cepa/aegir-gps-tracker/firmware/Core/Src/main.c

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
/* Includes ------------------------------------------------------------------*/
#include "main.h"
#include "cmsis_os.h"
#include "fatfs.h"

/* USER CODE BEGIN Includes */

#include <stdio.h>
#include "debug.h"
#include "softuart.h"
#include "ssd1306.h"
#include "ssd1306_fonts.h"
#include "i2c.h"
#include "display.h"
#include "gps.h"
#include "lte.h"
#include "iridium.h"
#include "report.h"

/* USER CODE END Includes */

I2C_HandleTypeDef hi2c1;

IWDG_HandleTypeDef hiwdg;

SPI_HandleTypeDef hspi1;
SPI_HandleTypeDef hspi2;

TIM_HandleTypeDef htim2;

UART_HandleTypeDef huart1;
UART_HandleTypeDef huart2;
UART_HandleTypeDef huart6;

osThreadId mainTaskHandle;
osThreadId displayTaskHandle;
osThreadId sdTaskHandle;
osThreadId gpsTaskHandle;
osThreadId lteTaskHandle;
osThreadId iridiumTaskHandle;
osThreadId keyTaskHandle;
osThreadId sensorTaskHandle;
/* USER CODE BEGIN PV */
extern QueueHandle_t sdQueue;
extern QueueHandle_t lteQueue;
extern QueueHandle_t iridiumQueue;
int lteCounter = 0;
int iridiumCounter = 3600 - 60 * 15; // 15 minutes to first Iridium beacon
/* USER CODE END PV */

void SystemClock_Config(void);
static void MX_GPIO_Init(void);
static void MX_I2C1_Init(void);
static void MX_SPI1_Init(void);
static void MX_SPI2_Init(void);
static void MX_USART1_UART_Init(void);
static void MX_USART2_UART_Init(void);
static void MX_USART6_UART_Init(void);
static void MX_TIM2_Init(void);
static void MX_IWDG_Init(void);
void Main_TaskHandler(void const * argument);
extern void Display_TaskHandler(void const * argument);
extern void SD_TaskHandler(void const * argument);
extern void GPS_TaskHandler(void const * argument);
extern void LTE_TaskHandler(void const * argument);
extern void Iridium_TaskHandler(void const * argument);
extern void Key_TaskHandler(void const * argument);
extern void Sensor_TaskHandler(void const * argument);

/* USER CODE BEGIN 0 */

/*
 * Override _write to forward stdout to SoftUart0
 */
int _write(int file, char *ptr, int len)
{
	int left = len;
	while (left > 0) {
		if (left > SoftUartTxBufferSize) {
			SoftUartPuts(0, (uint8_t *) ptr, SoftUartTxBufferSize);
			SoftUartWaitUntilTxComplate(0);
			left -= SoftUartTxBufferSize;
		} else {
			SoftUartPuts(0, (uint8_t *) ptr, left);
			SoftUartWaitUntilTxComplate(0);
			left -= left;
		}
	}
	return len;
}

void HAL_UART_TxCpltCallback(UART_HandleTypeDef *huart)
{
	// dummy
}

void HAL_UART_RxCpltCallback(UART_HandleTypeDef *huart)
{
	// GPS
	if (huart->Instance == USART1) {
		GPS_UART_Callback();
	}

	// LTE
	if (huart->Instance == USART2) {
		LTE_UART_Callback();
	}

	// IRIDIUM
	if (huart->Instance == USART6) {
		Iridium_UART_Callback();
	}
}

/* USER CODE END 0 */

/**
  * @brief  The application entry point.
  * @retval int
  */
int main(void)
{
  /* MCU Configuration--------------------------------------------------------*/

  /* Reset of all peripherals, Initializes the Flash interface and the Systick. */
  HAL_Init();

  /* Configure the system clock */
  SystemClock_Config();

  /* Initialize all configured peripherals */
  MX_GPIO_Init();
  MX_I2C1_Init();
  MX_SPI1_Init();
  MX_SPI2_Init();
  MX_USART1_UART_Init();
  MX_USART2_UART_Init();
  MX_USART6_UART_Init();
  MX_FATFS_Init();
  MX_TIM2_Init();
  MX_IWDG_Init();
  /* USER CODE BEGIN 2 */

  // Enable SoftUart0
  HAL_TIM_Base_Start_IT(&htim2);
  SoftUartInit(0, SOFT_TX0_GPIO_Port, SOFT_TX0_Pin, SOFT_RX0_GPIO_Port, SOFT_RX0_Pin);
  SoftUartPuts(0, (uint8_t *) "                ", 16);
  SoftUartPuts(0, (uint8_t *) "\r\n\r\n\r\n\r\n", 8);
  SoftUartWaitUntilTxComplate(0);

  // Init display
  Display_Init();
  Display_RenderBootScreen();

  // Hello
  HAL_Delay(100);
  _DEBUG("GPS Tracker v5");

  // Scan devices
  I2C_Scan(hi2c1);

  /* USER CODE END 2 */

  /* USER CODE BEGIN RTOS_MUTEX */
  /* add mutexes, ... */
  /* USER CODE END RTOS_MUTEX */

  /* USER CODE BEGIN RTOS_SEMAPHORES */
  /* add semaphores, ... */
  /* USER CODE END RTOS_SEMAPHORES */

  /* USER CODE BEGIN RTOS_TIMERS */
  /* start timers, add new ones, ... */
  /* USER CODE END RTOS_TIMERS */

  /* USER CODE BEGIN RTOS_QUEUES */
  sdQueue = xQueueCreate(10, sizeof (Report_t));
  lteQueue = xQueueCreate(500, sizeof (Report_t));
  iridiumQueue = xQueueCreate(24, sizeof (Report_t));
  /* USER CODE END RTOS_QUEUES */

  /* Create the thread(s) */
  /* definition and creation of mainTask */
  osThreadDef(mainTask, Main_TaskHandler, osPriorityLow, 0, 128);
  mainTaskHandle = osThreadCreate(osThread(mainTask), NULL);

  /* definition and creation of displayTask */
  osThreadDef(displayTask, Display_TaskHandler, osPriorityHigh, 0, 512);
  displayTaskHandle = osThreadCreate(osThread(displayTask), NULL);

  /* definition and creation of sdTask */
  osThreadDef(sdTask, SD_TaskHandler, osPriorityHigh, 0, 1024);
  sdTaskHandle = osThreadCreate(osThread(sdTask), NULL);

  /* definition and creation of gpsTask */
  osThreadDef(gpsTask, GPS_TaskHandler, osPriorityNormal, 0, 512);
  gpsTaskHandle = osThreadCreate(osThread(gpsTask), NULL);

  /* definition and creation of lteTask */
  osThreadDef(lteTask, LTE_TaskHandler, osPriorityNormal, 0, 1024);
  lteTaskHandle = osThreadCreate(osThread(lteTask), NULL);

  /* definition and creation of iridiumTask */
  osThreadDef(iridiumTask, Iridium_TaskHandler, osPriorityNormal, 0, 1024);
  iridiumTaskHandle = osThreadCreate(osThread(iridiumTask), NULL);

  /* definition and creation of keyTask */
  osThreadDef(keyTask, Key_TaskHandler, osPriorityLow, 0, 512);
  keyTaskHandle = osThreadCreate(osThread(keyTask), NULL);

  /* definition and creation of sensorTask */
  //osThreadDef(sensorTask, Sensor_TaskHandler, osPriorityLow, 0, 512);
  //sensorTaskHandle = osThreadCreate(osThread(sensorTask), NULL);

  /* USER CODE BEGIN RTOS_THREADS */
  /* add threads, ... */
  /* USER CODE END RTOS_THREADS */

  /* Start scheduler */
  osKernelStart();

  /* We should never get here as control is now taken by the scheduler */
  /* Infinite loop */
  /* USER CODE BEGIN WHILE */
  while (1)
  {
    /* USER CODE END WHILE */

    /* USER CODE BEGIN 3 */
  }
  /* USER CODE END 3 */
}

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
/* USER CODE BEGIN Header_Main_TaskHandler */
/**
  * @brief  Function implementing the mainTask thread.
  * @param  argument: Not used
  * @retval None
  */
/* USER CODE END Header_Main_TaskHandler */
void Main_TaskHandler(void const * argument)
{
  /* USER CODE BEGIN 5 */
  /* Infinite loop */

  Report_t report, reportDump;
  char buf[24];
  int reportStatus;

  for(;;)
  {
	// Blink LED
	HAL_GPIO_WritePin(LED_GPIO_Port, LED_Pin, GPIO_PIN_RESET);
    osDelay(200);
	HAL_GPIO_WritePin(LED_GPIO_Port, LED_Pin, GPIO_PIN_SET);
    osDelay(800);

    lteCounter++;
    iridiumCounter++;

    // Prepare report
    reportStatus = PrepareReport(&report);

    // Send report to SD card
    if (reportStatus == REPORT_OK) {
    	xQueueSend(sdQueue, &report, 10);

    	if (lteCounter > 10) {
    		lteCounter = 0;

        	// If full take the last element
        	if (uxQueueSpacesAvailable(lteQueue) == 0) {
        		xQueueReceive(lteQueue, &reportDump, 10);
        	}

        	xQueueSend(lteQueue, &report, 0);
    	}

    	if (iridiumCounter > 3600) {
    		iridiumCounter = 0;

        	// If full take the last element
        	if (uxQueueSpacesAvailable(iridiumQueue) == 0) {
        		xQueueReceive(iridiumQueue, &reportDump, 10);
    			_DEBUG("Iridium messages waiting: %d", uxQueueMessagesWaiting(iridiumQueue));
        	}

        	// Add current report
    		xQueueSend(iridiumQueue, &report, 0);
    	}
    }

    // Status update
    if (!Display_StatusIsLocked()) {
		if (lastReportSendTime > 0) {
			PrintfLock();
			snprintf(buf, 24, "Report sent %ds ago", (HAL_GetTick() - lastReportSendTime) / 1000);
			PrintfUnlock();

			Display_SetStatus(buf);
		} else {
			Display_SetStatus("Report not sent yet");
		}
    }

    // Reset Watchdog
    HAL_IWDG_Refresh(&hiwdg);
  }
  /* USER CODE END 5 */
}

/**
  * @brief  Period elapsed callback in non blocking mode
  * @note   This function is called  when TIM1 interrupt took place, inside
  * HAL_TIM_IRQHandler(). It makes a direct call to HAL_IncTick() to increment
  * a global variable "uwTick" used as application time base.
  * @param  htim : TIM handle
  * @retval None
  */
void HAL_TIM_PeriodElapsedCallback(TIM_HandleTypeDef *htim)
{
  if (htim->Instance == TIM1) {
    HAL_IncTick();
  }
  /* USER CODE BEGIN Callback 1 */

  if (htim->Instance == TIM2) {
	  SoftUartHandler();
  }

  /* USER CODE END Callback 1 */
}

/**
  * @brief  This function is executed in case of error occurrence.
  * @retval None
  */
void Error_Handler(void)
{
  /* USER CODE BEGIN Error_Handler_Debug */
  /* User can add his own implementation to report the HAL error return state */
  __disable_irq();
  while (1)
  {
  }
  /* USER CODE END Error_Handler_Debug */
}

#ifdef  USE_FULL_ASSERT
/**
  * @brief  Reports the name of the source file and the source line number
  *         where the assert_param error has occurred.
  * @param  file: pointer to the source file name
  * @param  line: assert_param error line source number
  * @retval None
  */
void assert_failed(uint8_t *file, uint32_t line)
{
  /* USER CODE BEGIN 6 */
  /* User can add his own implementation to report the file name and line number,
     ex: printf("Wrong parameters value: file %s on line %d\r\n", file, line) */
  /* USER CODE END 6 */
}
#endif /* USE_FULL_ASSERT */
