cepa/aegir-gps-tracker/firmware/Core/Inc/main.h

#define LED_Pin GPIO_PIN_13
#define LED_GPIO_Port GPIOC
#define OLED_RST_Pin GPIO_PIN_0
#define OLED_RST_GPIO_Port GPIOB
#define OLED_DC_Pin GPIO_PIN_1
#define OLED_DC_GPIO_Port GPIOB
#define OLED_CS_Pin GPIO_PIN_2
#define OLED_CS_GPIO_Port GPIOB
#define SD_CS_Pin GPIO_PIN_12
#define SD_CS_GPIO_Port GPIOB
#define IR_NET_Pin GPIO_PIN_15
#define IR_NET_GPIO_Port GPIOA
#define KEY1_Pin GPIO_PIN_3
#define KEY1_GPIO_Port GPIOB
#define KEY2_Pin GPIO_PIN_4
#define KEY2_GPIO_Port GPIOB
#define SOFT_RX0_Pin GPIO_PIN_8
#define SOFT_RX0_GPIO_Port GPIOB
#define SOFT_TX0_Pin GPIO_PIN_9
#define SOFT_TX0_GPIO_Port GPIOB
#define SD_SPI_HANDLE hspi2
